ib130258/DCF77-Nixie-Clock/Schematic_Nixie Clock_2021-12-28_Sheet_1.pdf

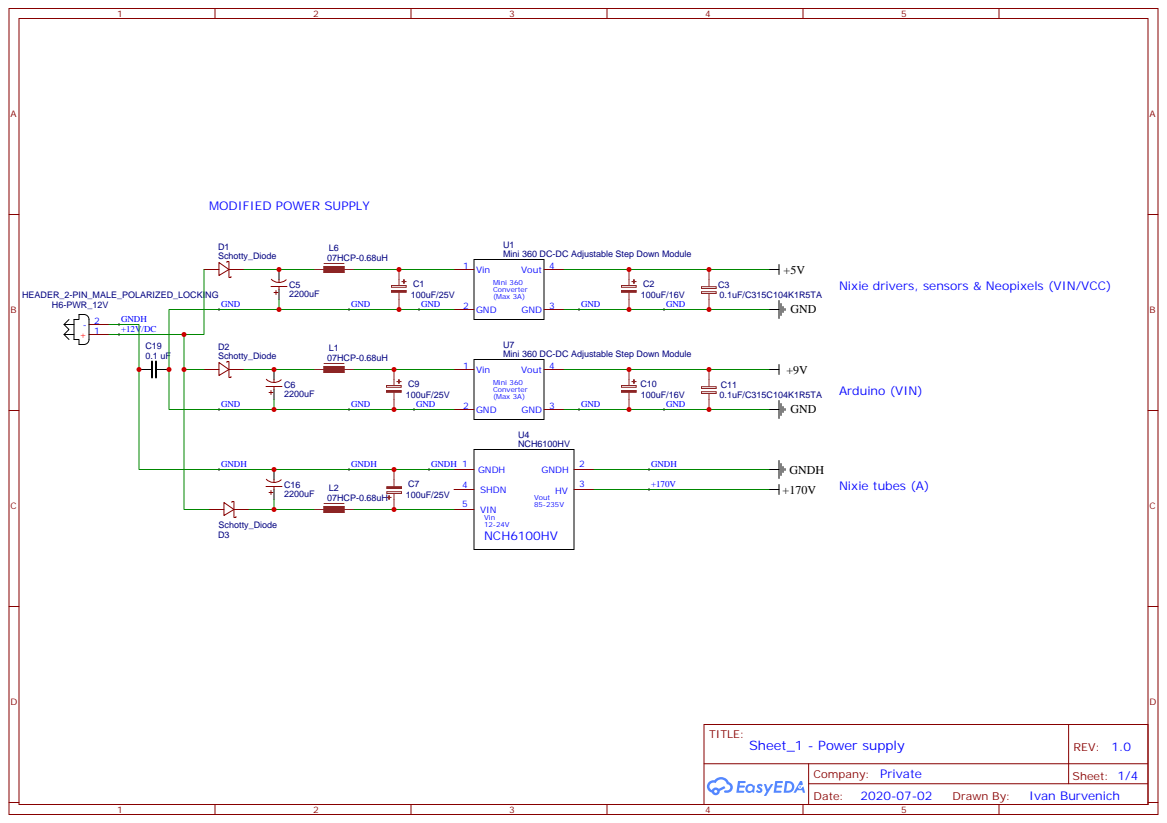
[picture p1: page 1]

Mini 360 DC-DC Adjustable Step Down Module
Vout 4

Nixie drivers, sensors & Neopixels (VIN/VCC)
