ib130258/DCF77-Nixie-Clock/Schematic_Nixie Clock_2021-12-28_Sheet_3.pdf

# C1407HCP⁻⁰.68uH L3

# U2EM²S DCF

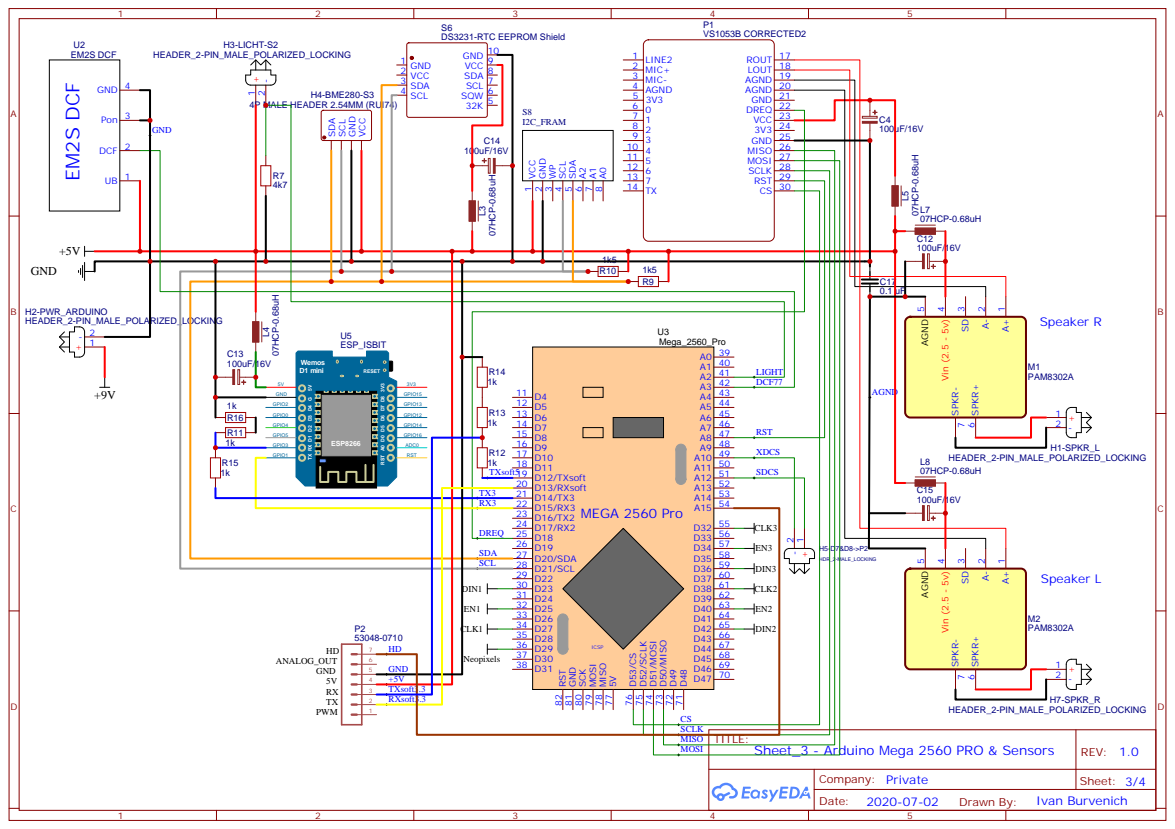
[picture p2: page 1]

H4-BME280-S3 SDA SCL GND VCC

ESP_ISBIT
Wemos TX RX D¹ D² D³ D⁴ G ⁵V
D1 mini

MEGA 2560 Pro D⁴⁸ 71 D⁴⁹ 72 D⁵⁰/MISO 73 D⁵¹/MOSI 74 D⁵²/SCLK 75 D⁵³/CS 76 5V 77 MISO 78 MOSI 79 SCK 80 GND 81 RST 82
