ib130258/DCF77-Nixie-Clock/Schematic_Nixie Clock_2021-12-28_Sheet_2.pdf

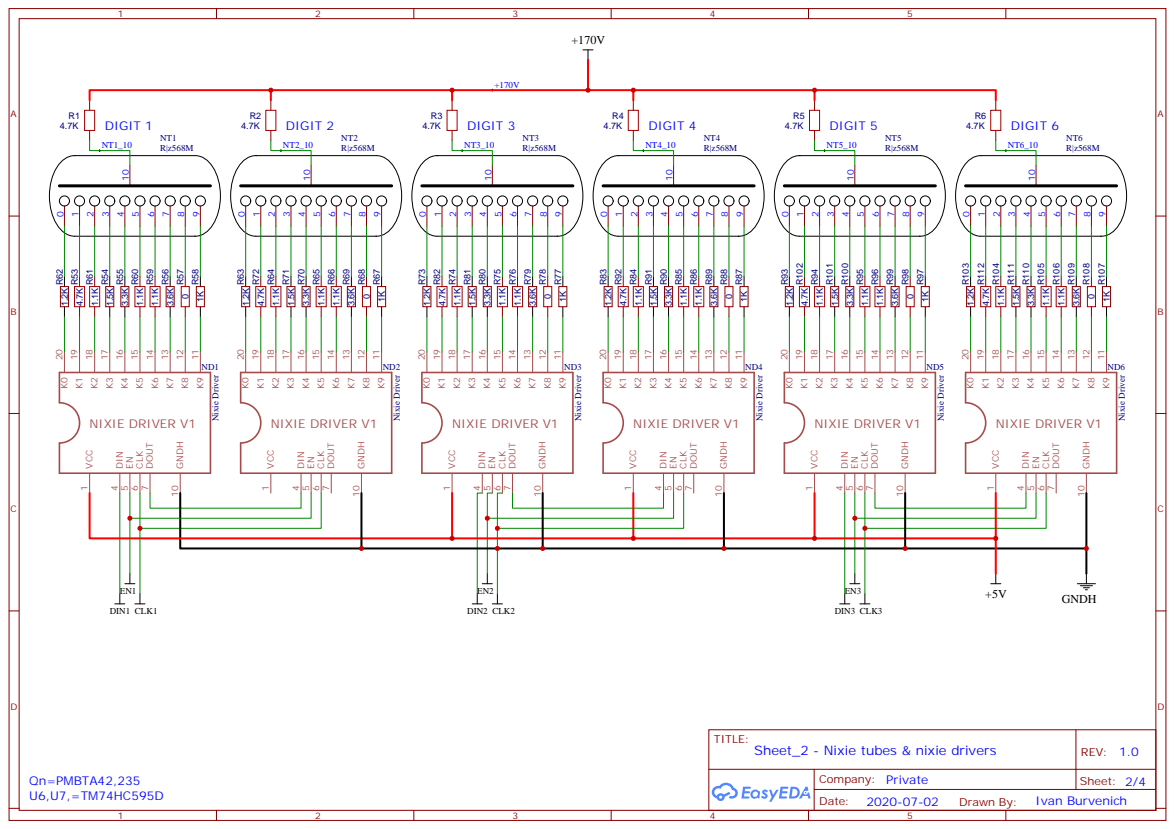
[picture p3: page 1]
