ib130258/DCF77-Nixie-Clock/Schematic_Nixie Clock_2021-12-28_Sheet_4.pdf

A | A

1

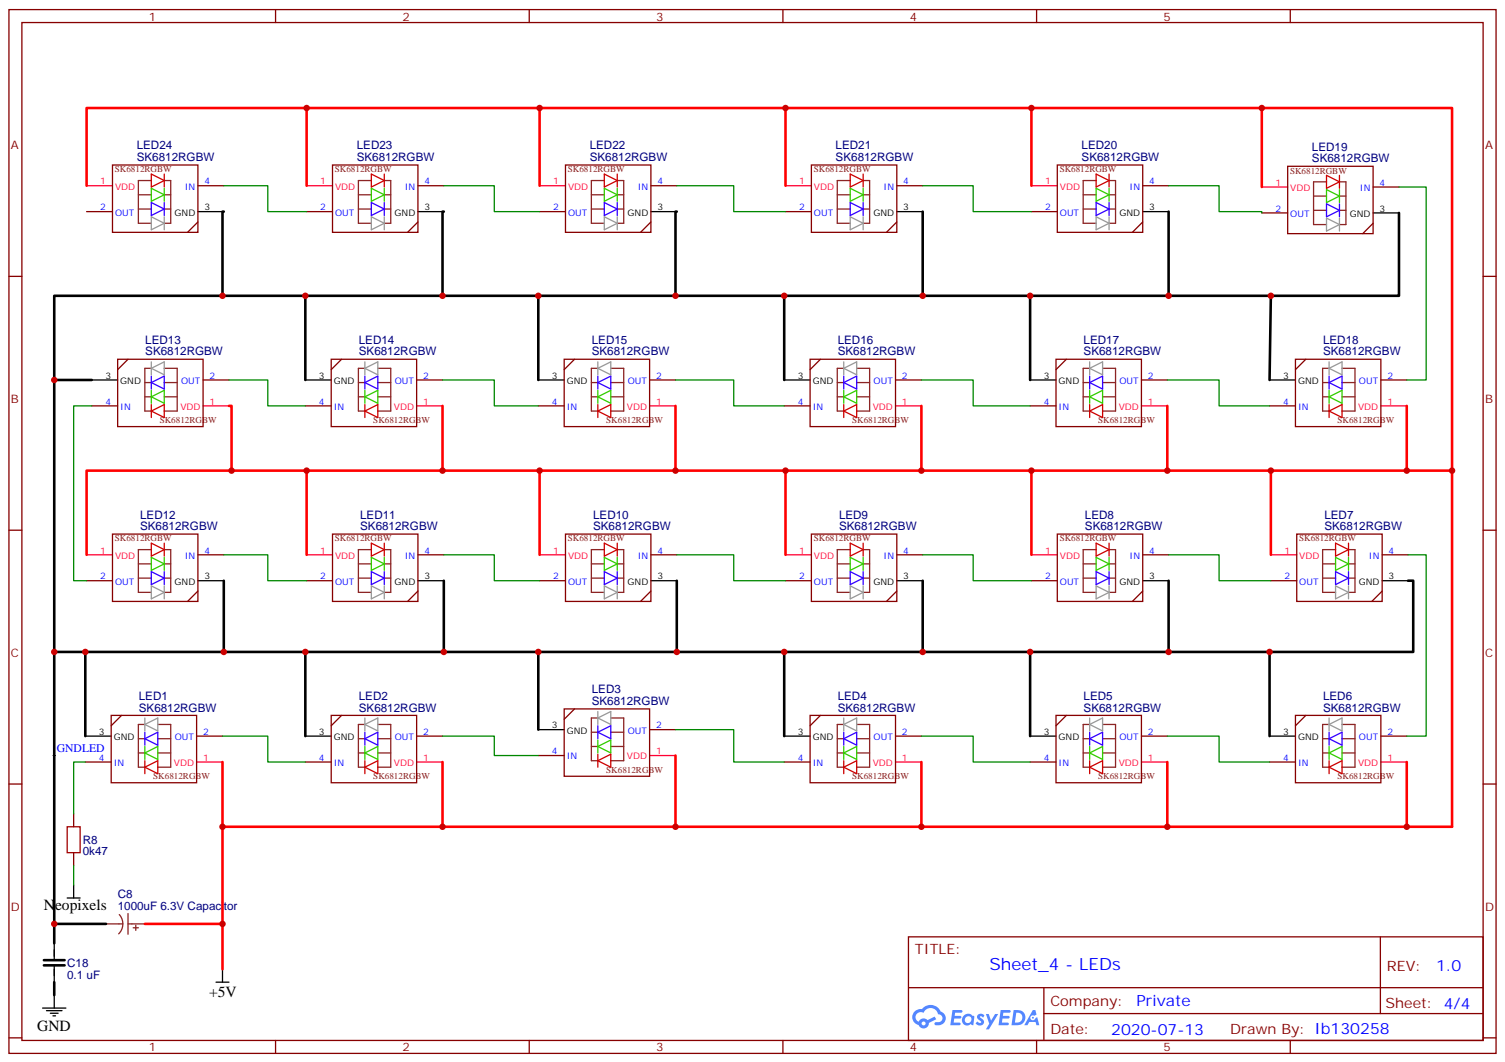
[picture p4: page 1]
